116guardian/Hydroponie-Automation/Drawing1-Diagram Hydroponie.pdf

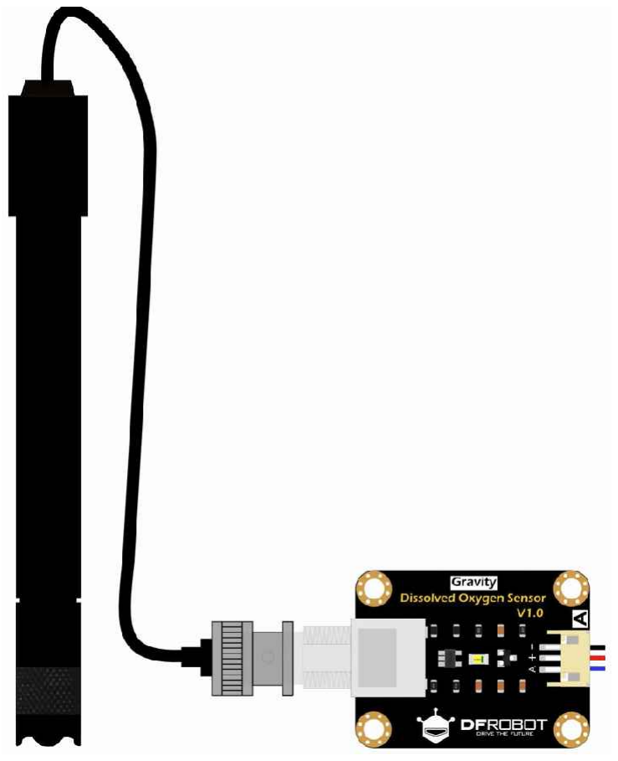
[picture p3: figure]

Sonde de Température de l'eau Sonde de Température de l'eau Capteur d'Oxygène dissous Sonde de pH | Pompe 4 Pompe 3 Pompe 2 Pompe 1 5VGND ~5VGND ~5VGND ~ | ESP32 microcontroller | 5V GND5V GND5V GND5V GND Système Hydroponie

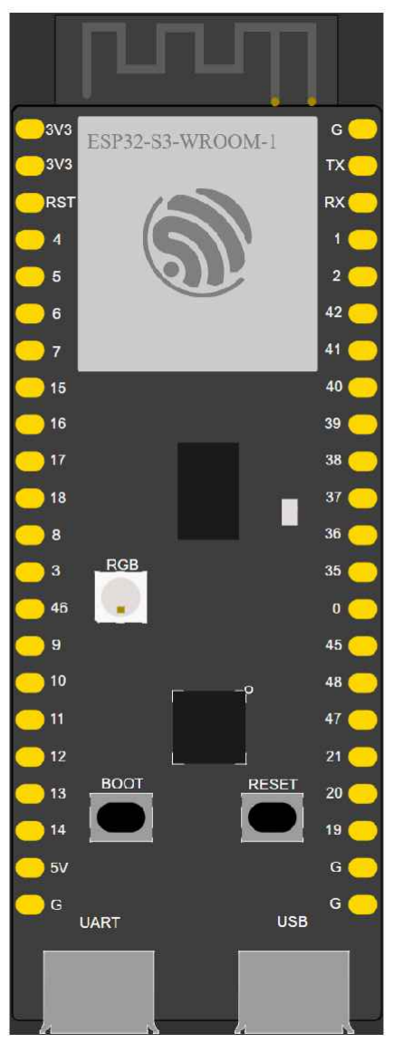
[picture p4: figure]
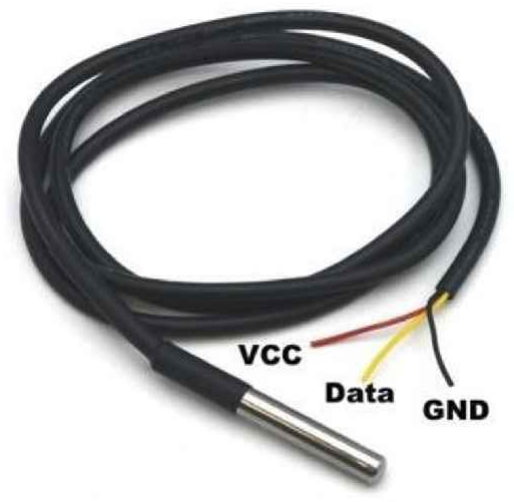
[picture p5: figure]
