116guardian/Hydroponie-Automation/docs/datasheets/pH_Sensor/PH-110-picture.jpg

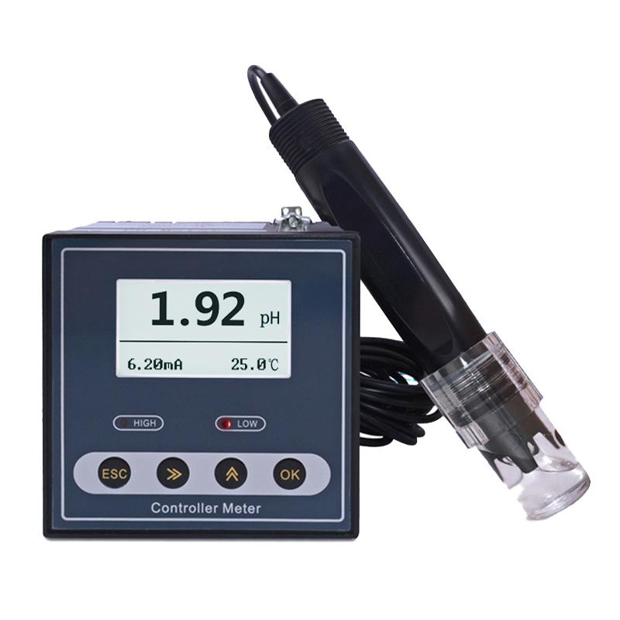
docs/datasheets/pH_Sensor/PH-110-picture.jpg
