116guardian/Hydroponie-Automation/hardware/control_board/images/Diagramme de Block-1.png

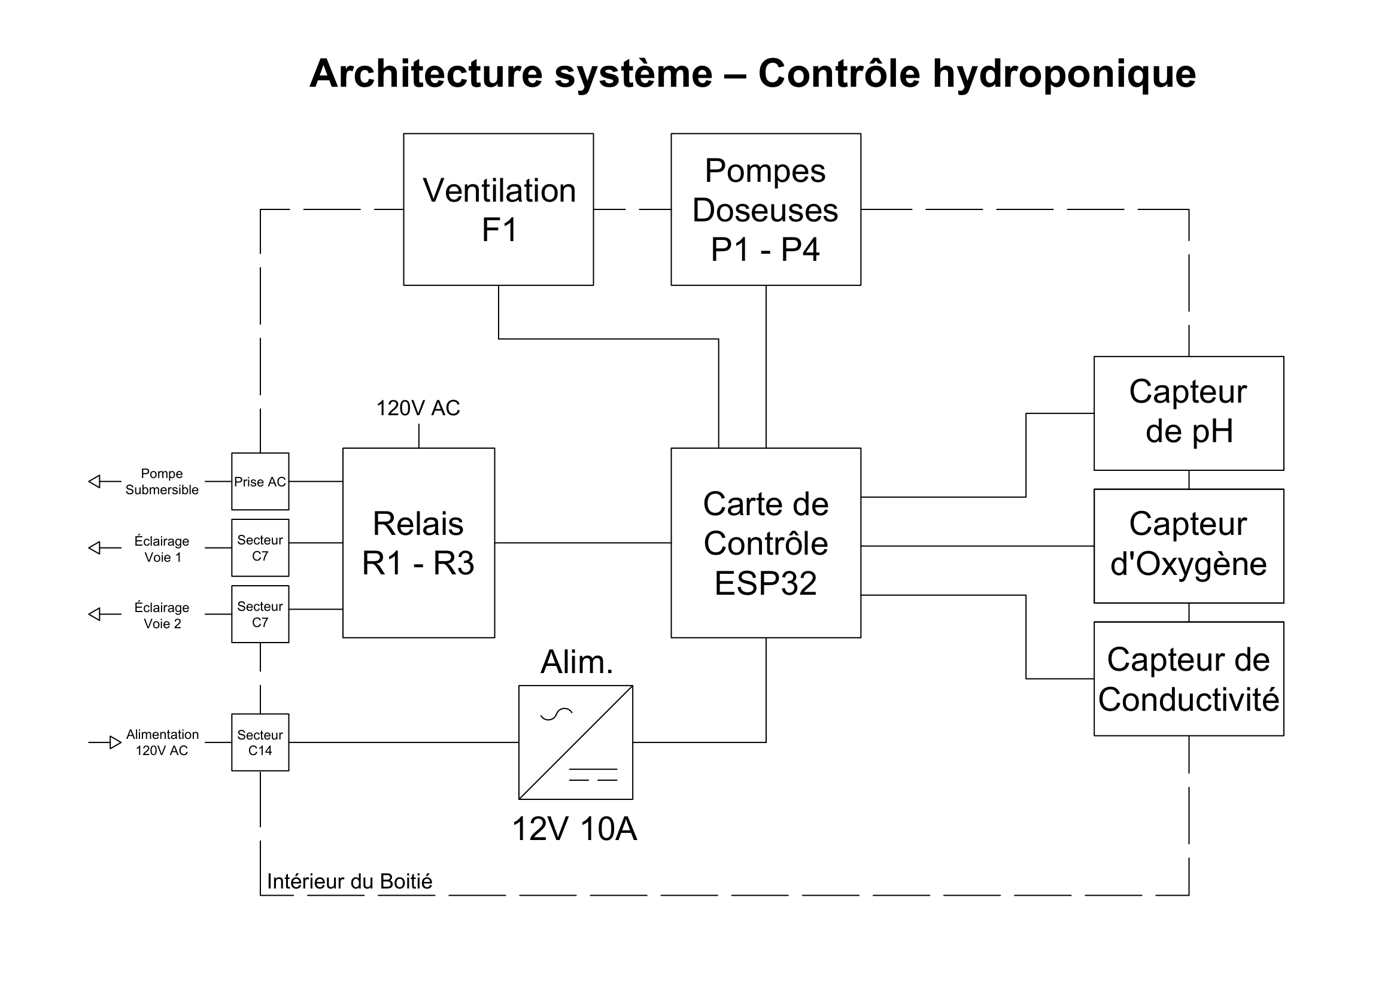
hardware/control_board/images/Diagramme de Block-1.png
