116guardian/Hydroponie-Automation/hardware/control_board/images/Diagramme_des_entrees-1.png

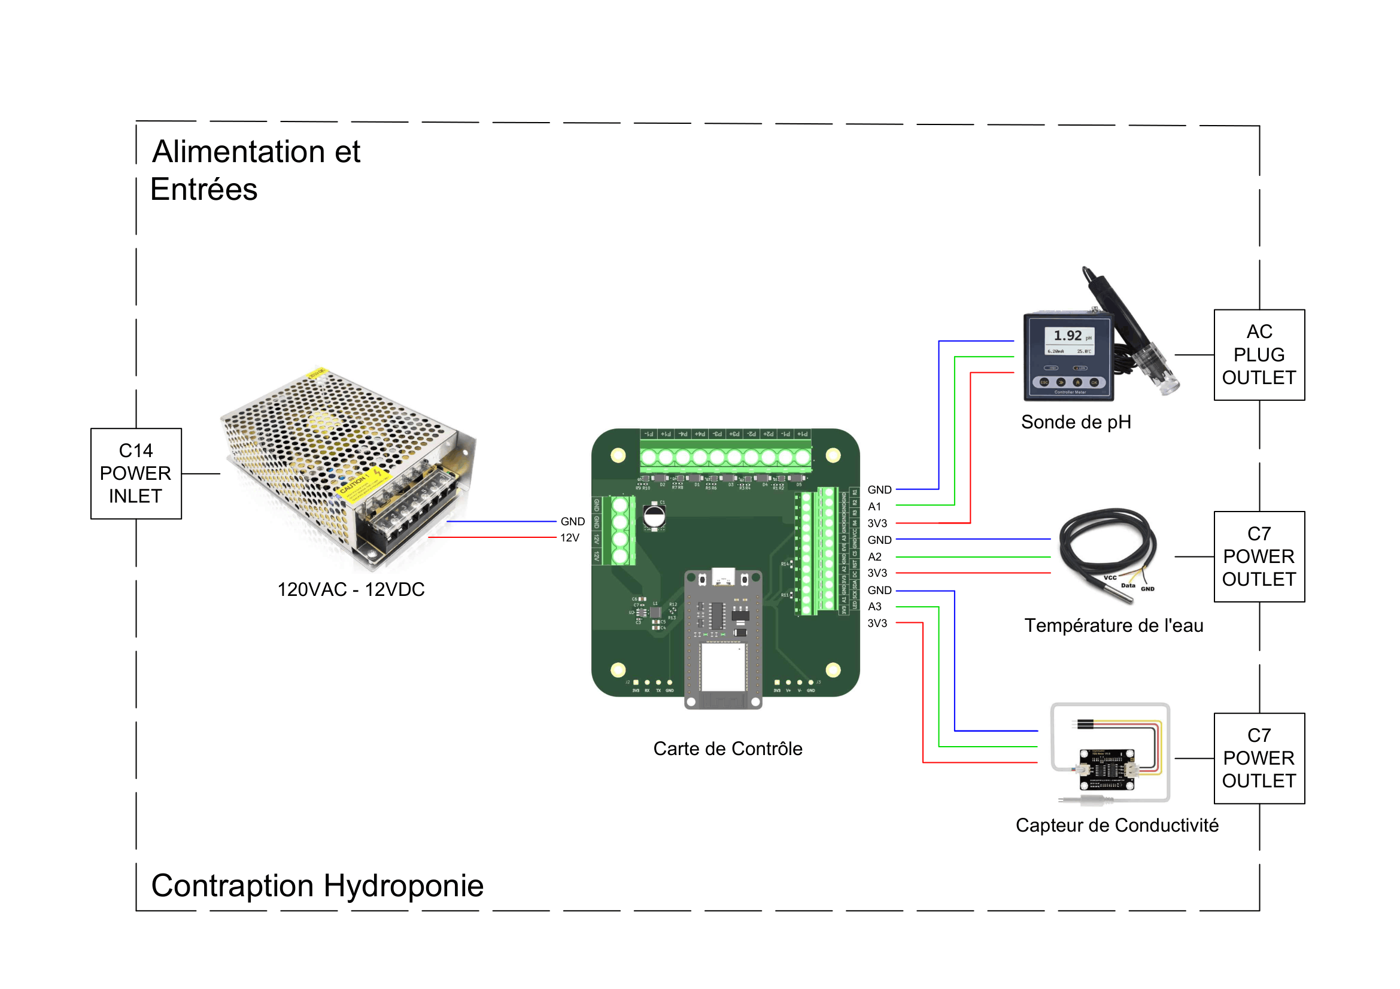
hardware/control_board/images/Diagramme_des_entrees-1.png
