116guardian/Hydroponie-Automation/hardware/control_board/images/Hydroponie_GFX-Diagramme de Branchement-1.png

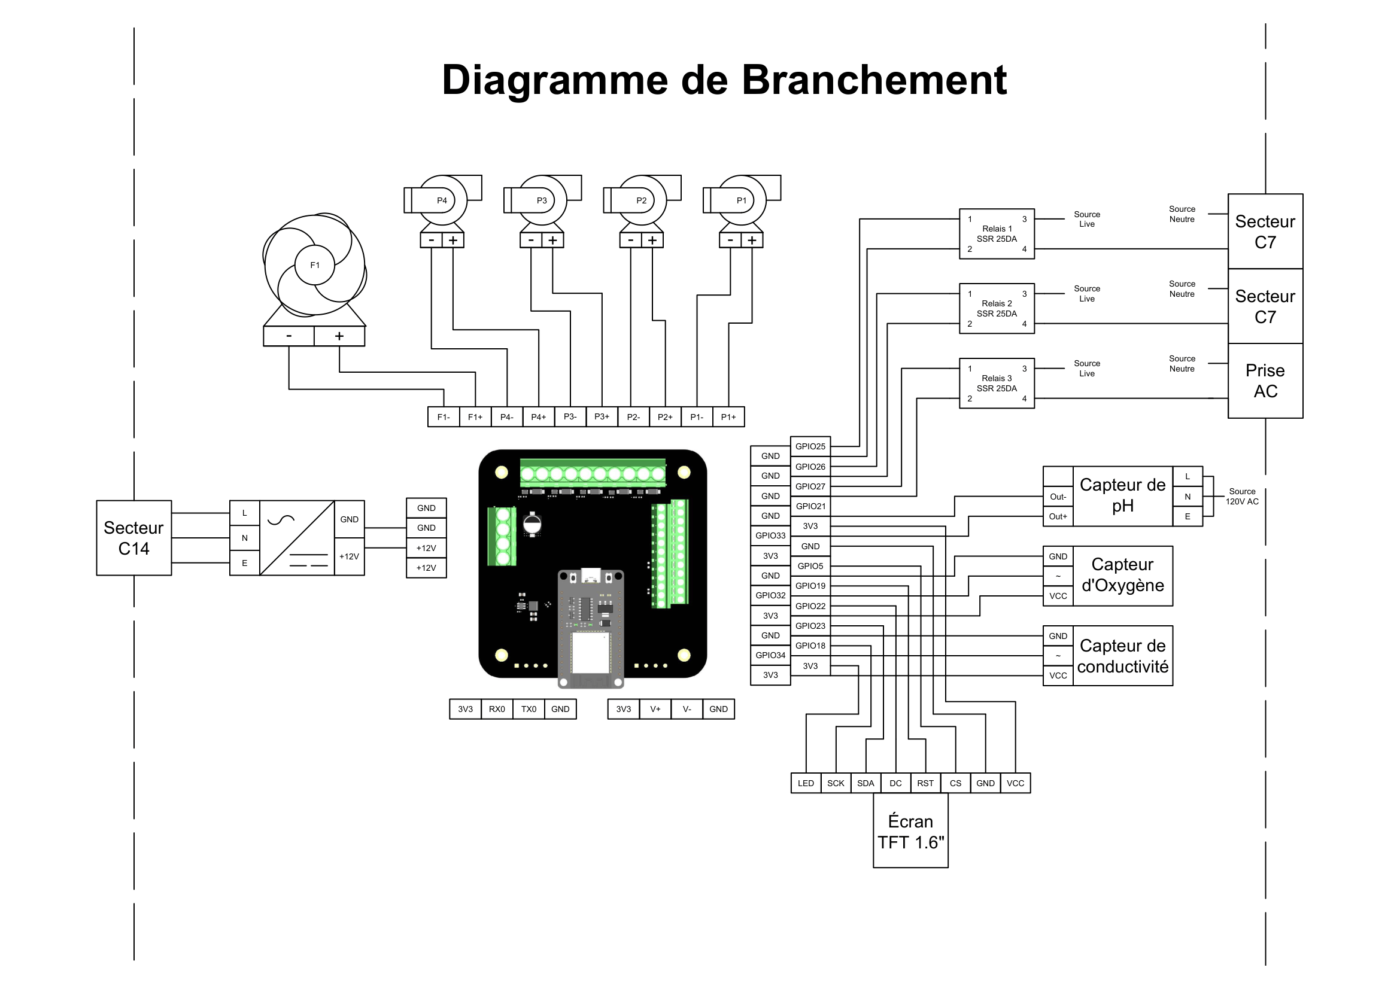
hardware/control_board/images/Hydroponie_GFX-Diagramme de Branchement-1.png
