116guardian/Hydroponie-Automation/hardware/control_board/images/Hydroponie_GFX-Pinout Simple-1.png

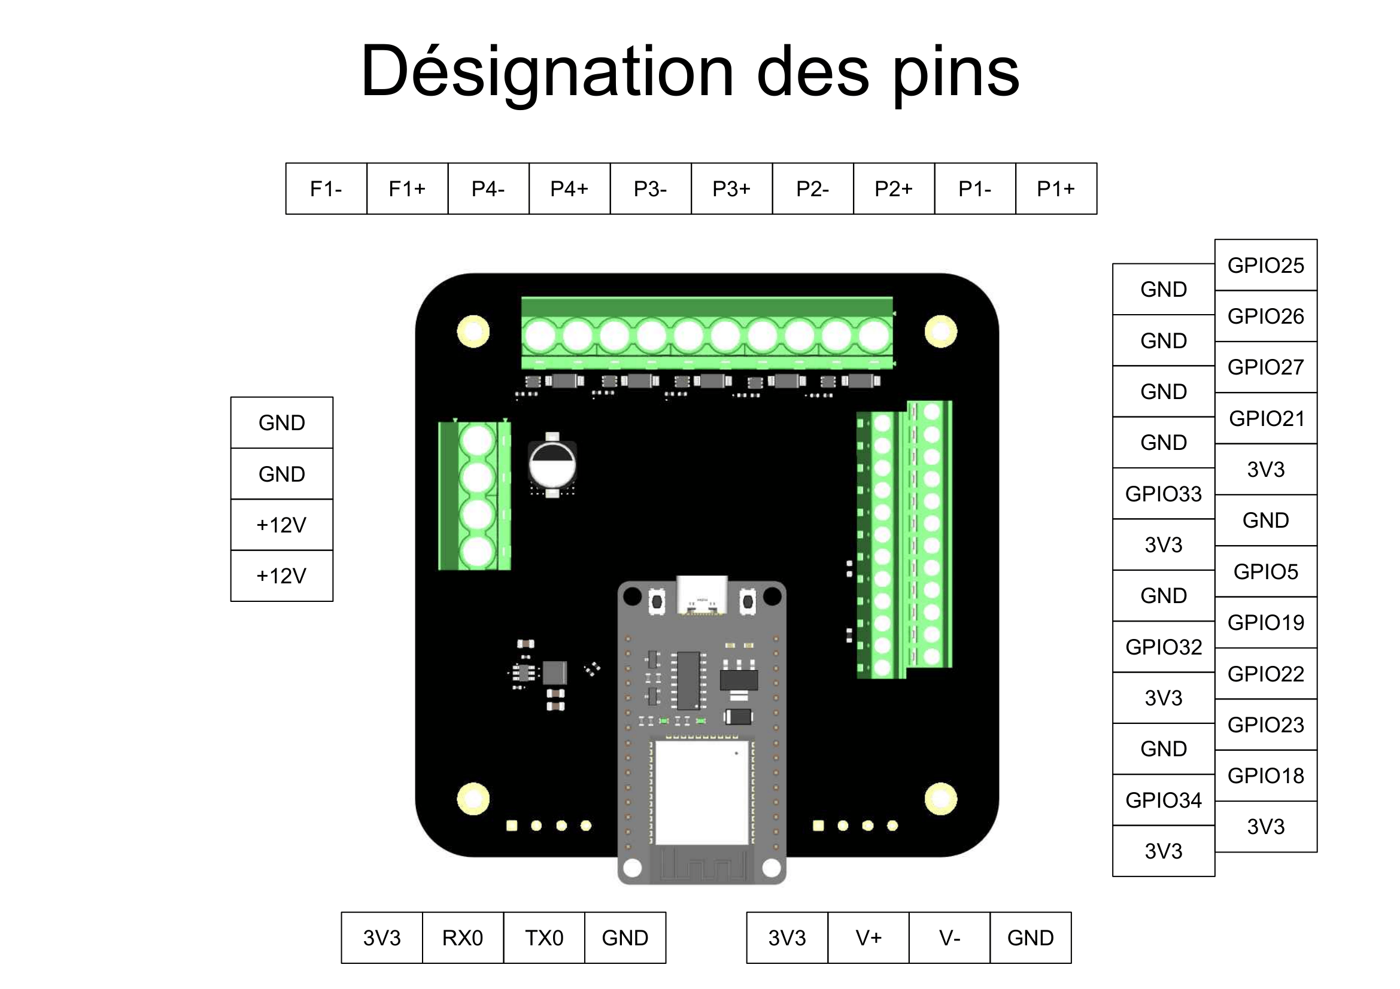
hardware/control_board/images/Hydroponie_GFX-Pinout Simple-1.png
