116guardian/Hydroponie-Automation/hardware/control_board/schematic/Schema_electrique_carte_de_controle-1.png

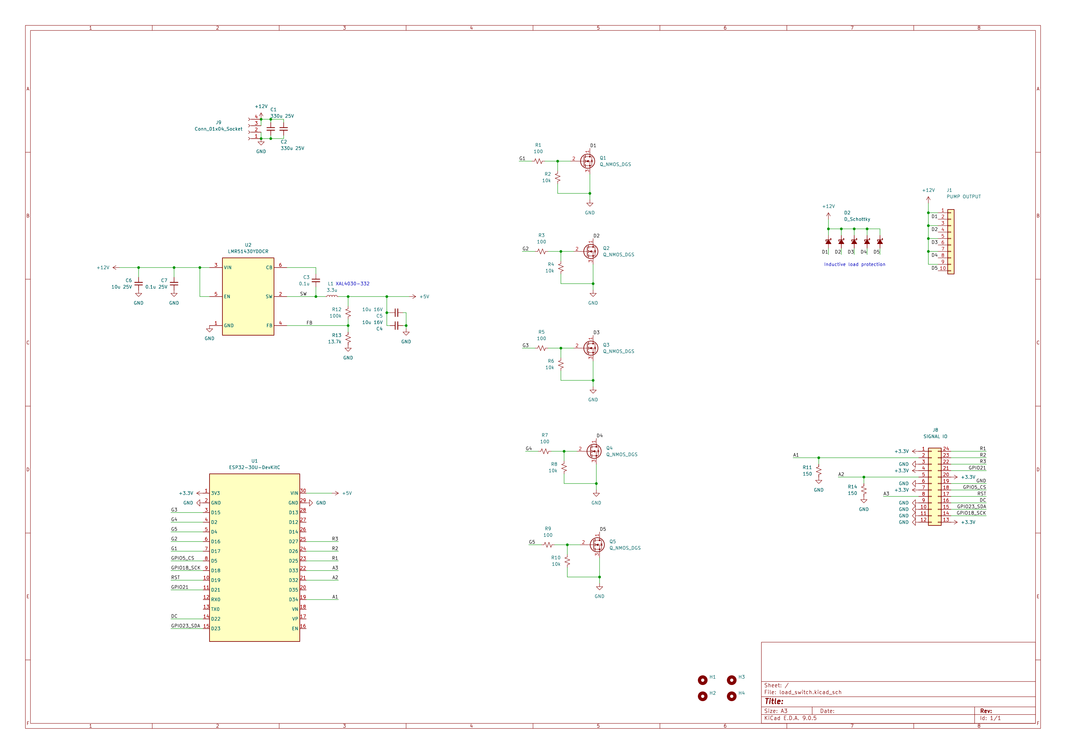
hardware/control_board/schematic/Schema_electrique_carte_de_controle-1.png
