116guardian/Hydroponie-Automation/hardware/mechanical/cad/Dimensions.PNG

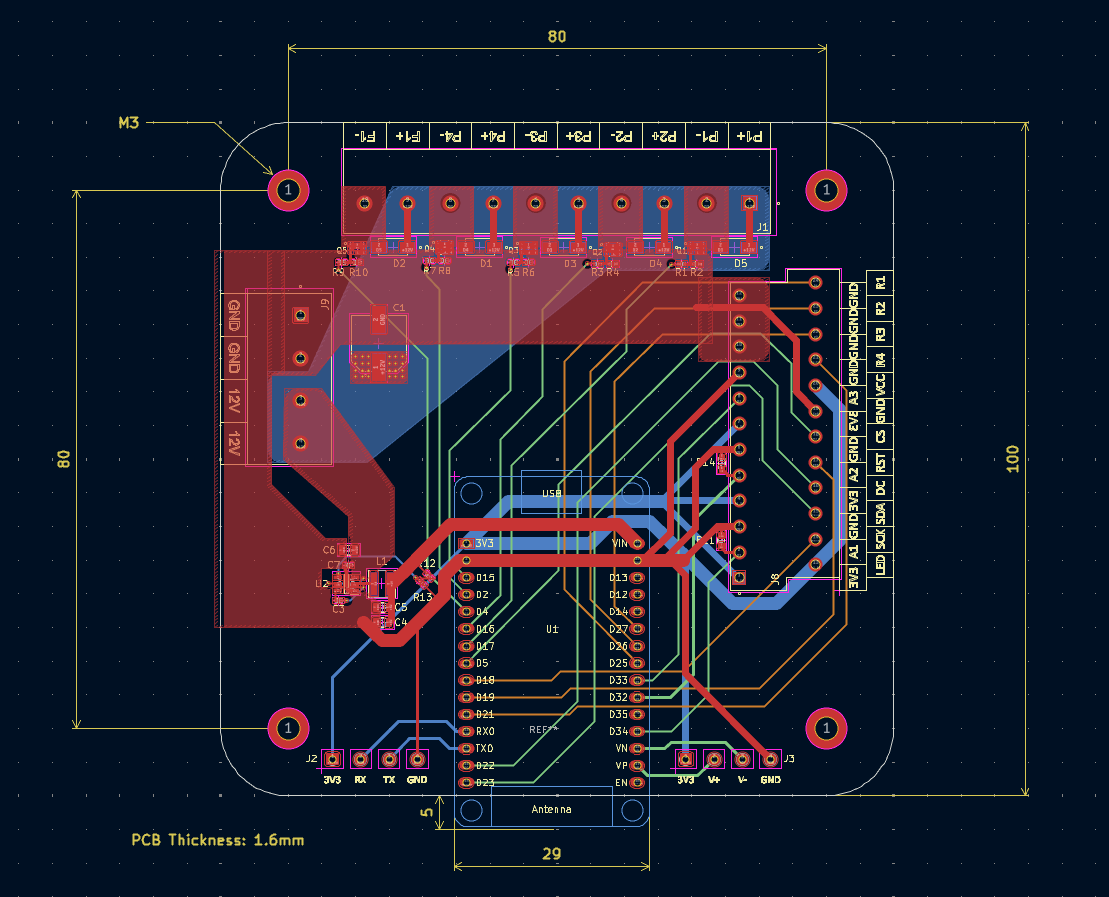
hardware/mechanical/cad/Dimensions.PNG
