116guardian/Hydroponie-Automation/hardware/control_board/images/esp32_30pin.SLDPRT

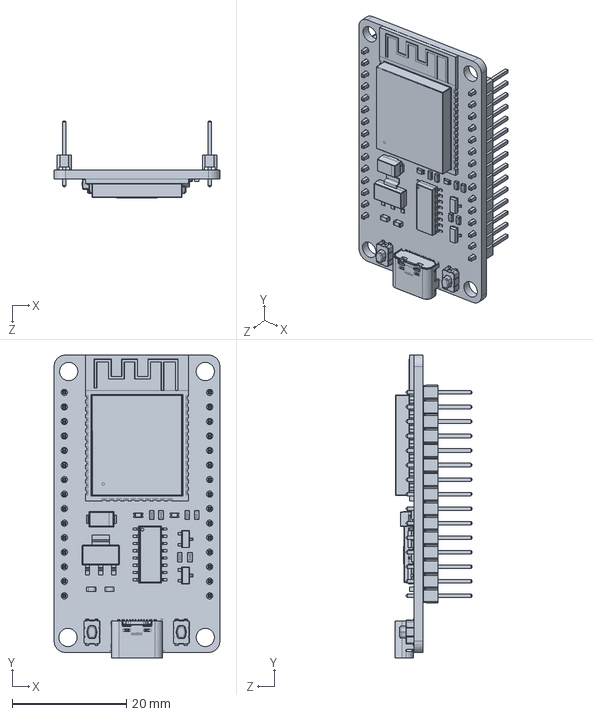
[picture p20: CAD file, 2026-07-29]
hardware/control_board/images/esp32_30pin.SLDPRT
29.0 x 53.0 x 13.5 mm
