116guardian/Hydroponie-Automation/(list of files, cad)

Other CAD files:
hardware/control_board/images/esp32_30pin.IGS
hardware/control_board/images/esp32_30pin.prt
hardware/control_board/images/esp32_30pin.x_t
