116guardian/Hydroponie-Automation/(commit log)

2026-07-20 Updated File Structure
    [bom.csv, positions.csv]
2026-07-20 Changed File Structure
    [bom.csv, positions.csv]
2026-07-29 Added CAD files
    [load_switch.step]
2026-07-29 Updated main board CAD export
    [esp32_30pin.IGS, esp32_30pin.SLDPRT, esp32_30pin.prt, esp32_30pin.x_t, load_switch.step]
